Subsystems-us/Three-Dimensional-Tic-Tac-Toe/TDTTT_Schematic_Lvl1.pdf

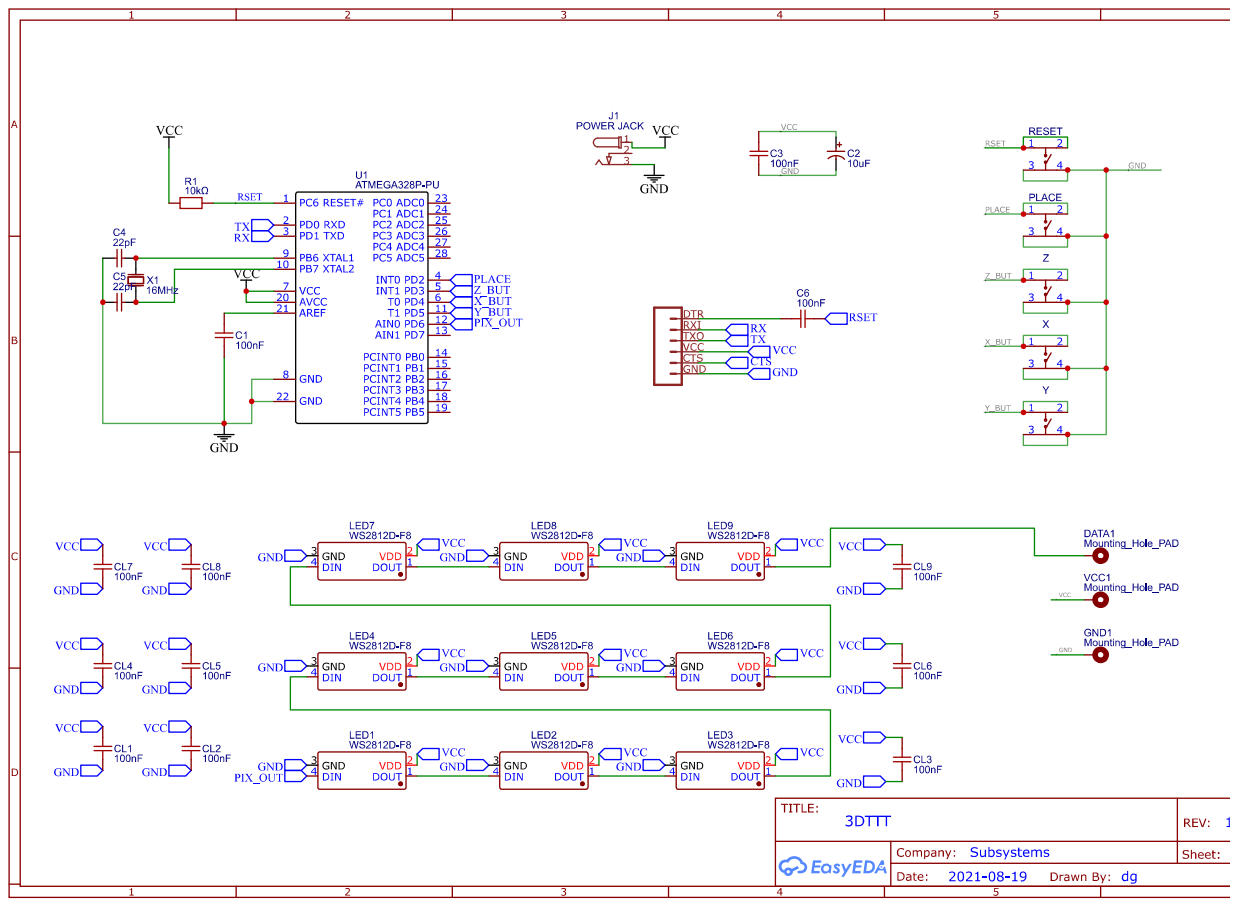
[picture p8: page 1]
