Subsystems-us/Three-Dimensional-Tic-Tac-Toe/TDTTT_Schematic_Lvl2.pdf

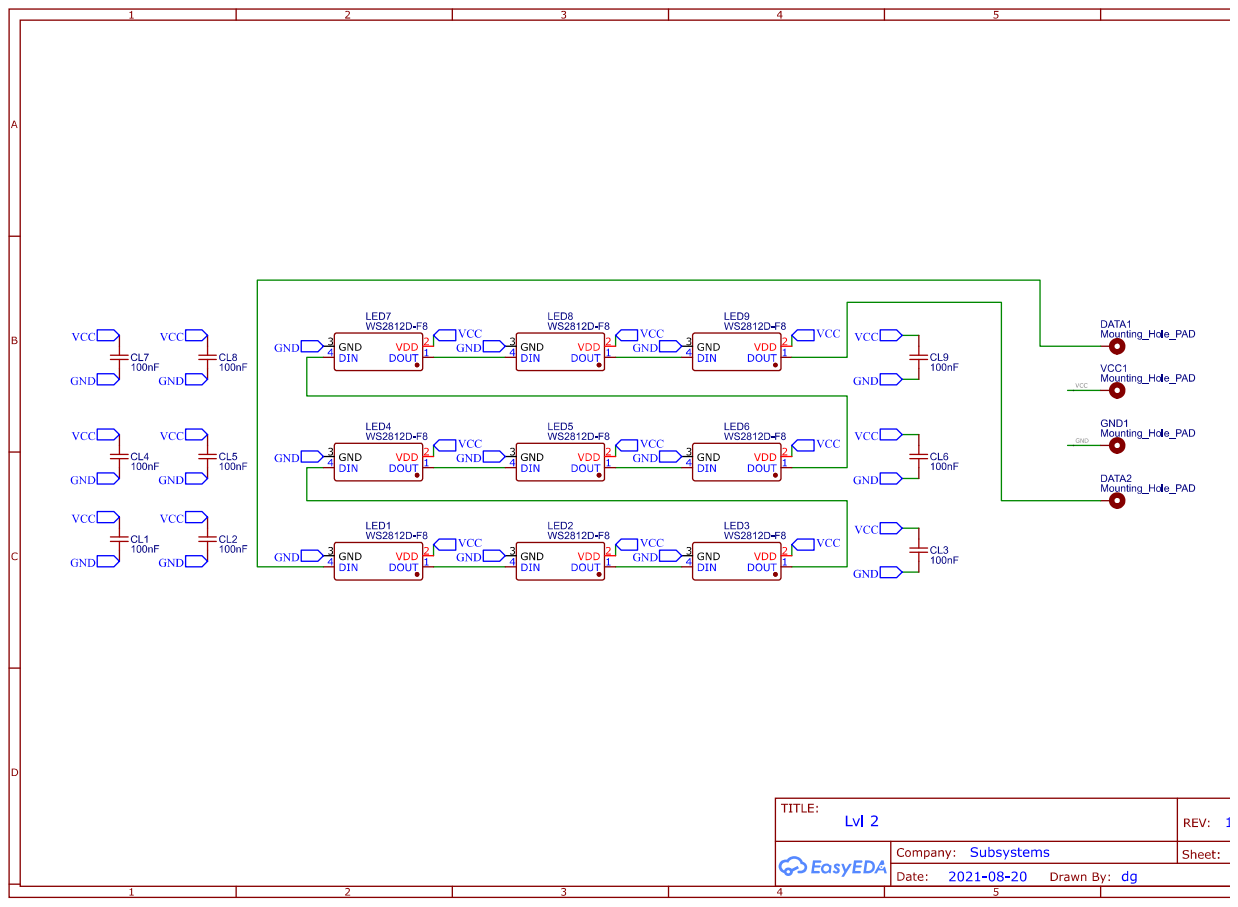
[picture p9: page 1]
