Subsystems-us/Three-Dimensional-Tic-Tac-Toe/TDTTT_Schematic_Lvl3.pdf

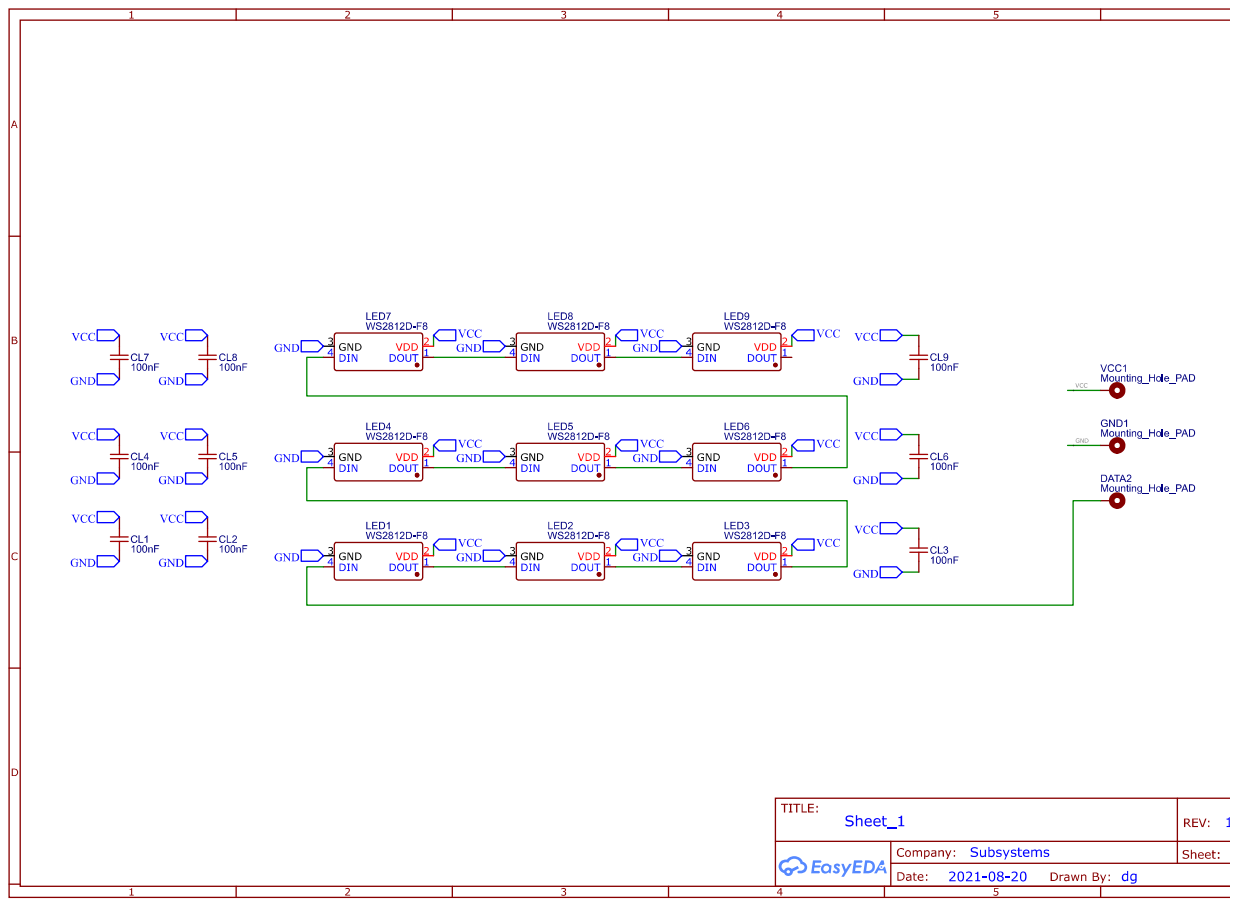
[picture p10: page 1]
