Subsystems-us/Three-Dimensional-Tic-Tac-Toe/(commit log)

2021-09-06 Arduino sketch for TDTTT
2021-09-06 Compiled Hex file
    In case you had problems compiling for some reason.
